Mario-dango/Tank/README.md

This is the first time that I make a real project, I want to do my best on it and finish
