Mario-dango/Tank/mother Tan-k/Archiv/drv8825_3D/8825.stp

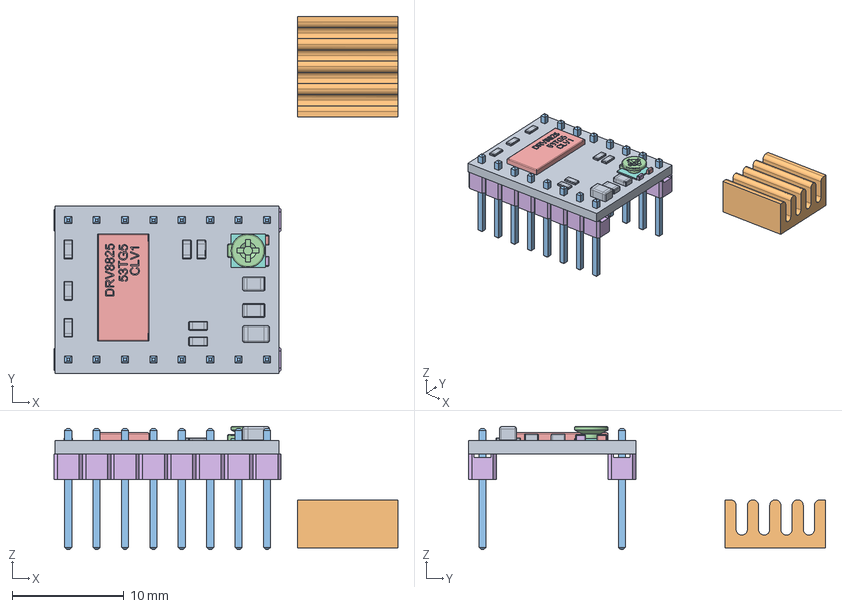
[picture p13: CAD file, 2021-11-19, an earlier design]
mother Tan-k/Archiv/drv8825_3D/8825.stp
30.8 x 31.9 x 11.0 mm
