Mario-dango/Tank/mother Tan-k/Otras versiones/PCB v1.1/Tan-k/Tan-k.kicad_pcb

## KiCad design mother Tan-k/Otras versiones/PCB v1.1/Tan-k/Tan-k.kicad_pcb (2021-11-19, an earlier design)

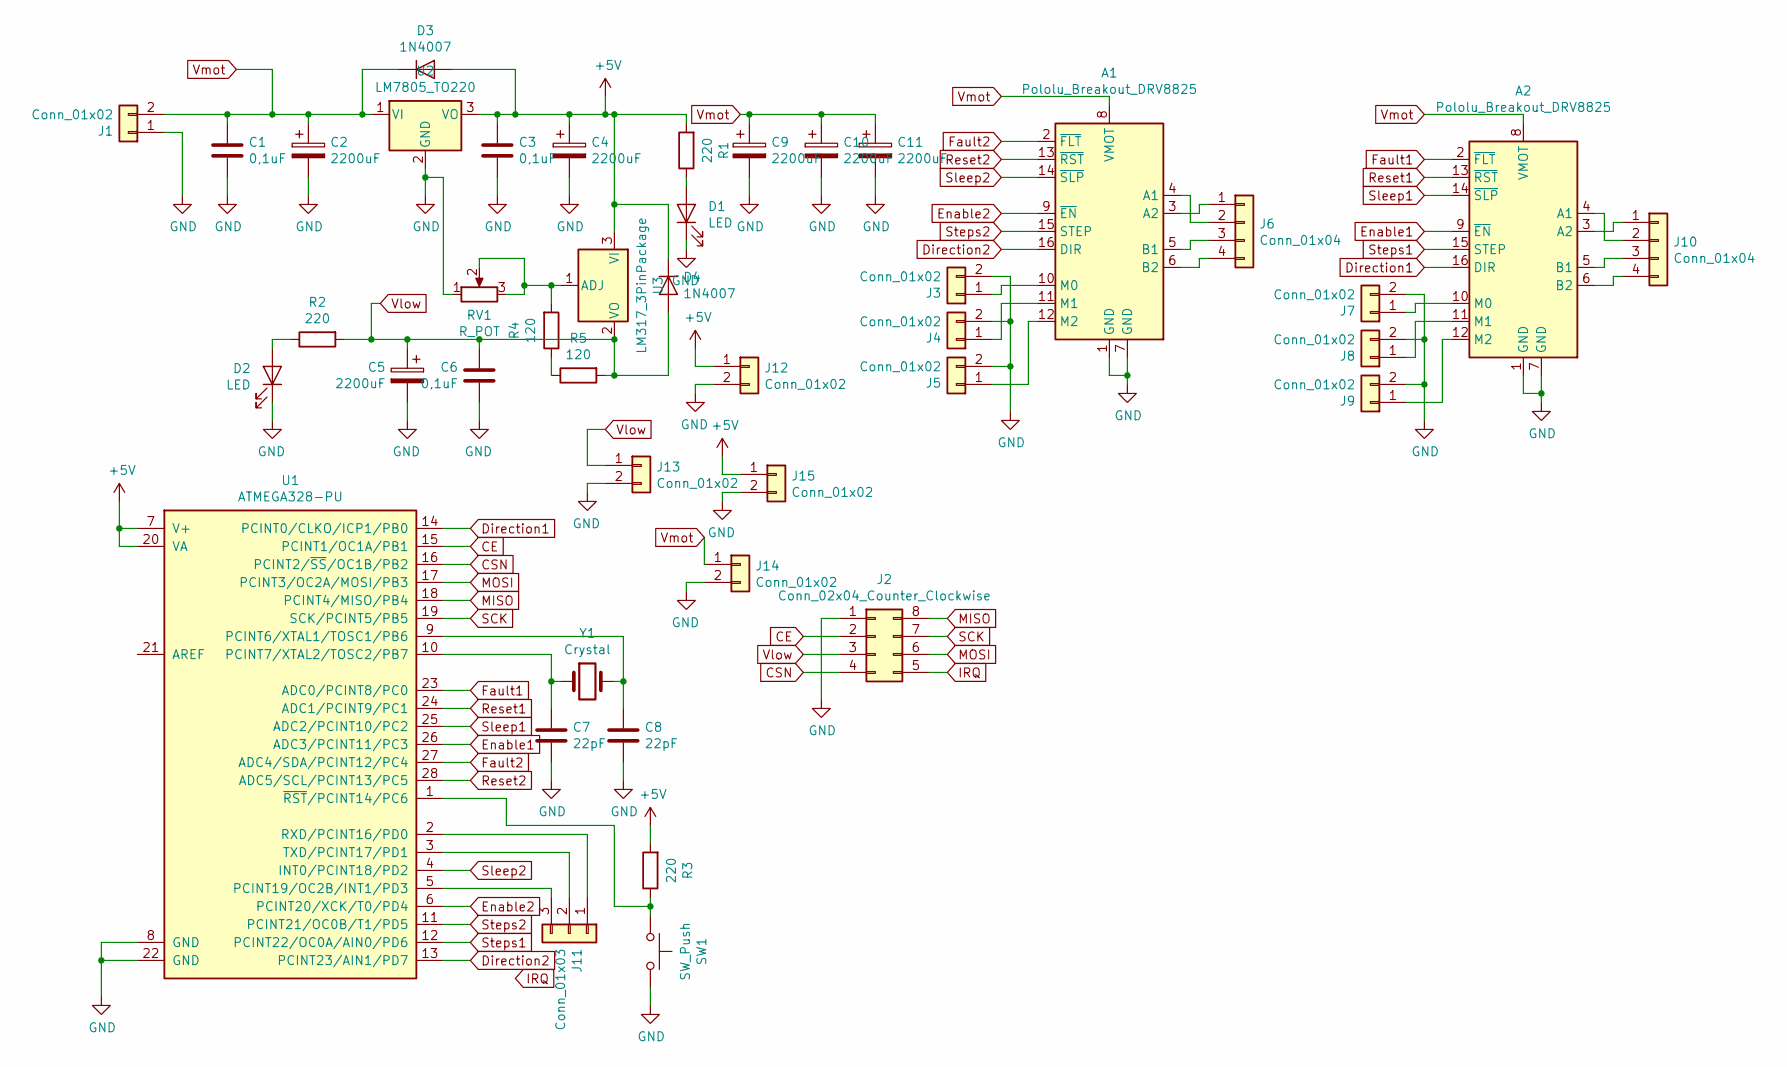
[picture p14: schematic Tan-k.sch]

Parts:
A1, A2: Pololu_Breakout_DRV8825; Pololu_Breakout-16_15.2x20.3mm
C1, C3, C6: 0,1uF; C_Disc_D5.0mm_W2.5mm_P5.00mm
C2, C5: 2200uF; CP_Radial_D10.0mm_P2.50mm_P5.00mm
C4, C9, C10, C11: 2200uF; CP_Radial_D13.0mm_P5.00mm
C7, C8: 22pF; C_Disc_D3.8mm_W2.6mm_P2.50mm
D1, D2: LED; LED_D5.0mm
D3, D4: 1N4007; D_DO-41_SOD81_P10.16mm_Horizontal
J1: Conn_01x02; PhoenixContact_MCV_1,5_2-G-5.08_1x02_P5.08mm_Vertical
J2: Conn_02x04_Counter_Clockwise; PinHeader_2x04_P2.54mm_Vertical
J3, J4, J5, J7, J8, J9, J12, J13, J14, J15: Conn_01x02; PinHeader_1x02_P2.54mm_Vertical
J6, J10: Conn_01x04; PinHeader_1x04_P2.54mm_Vertical
J11: Conn_01x03; PinHeader_1x03_P2.54mm_Vertical
R1, R2, R3: 220; R_Axial_DIN0207_L6.3mm_D2.5mm_P10.16mm_Horizontal
R4, R5: 120; R_Axial_DIN0207_L6.3mm_D2.5mm_P10.16mm_Horizontal
RV1: R_POT; Potentiometer_Bourns_3266X_Horizontal
SW1: SW_Push; SW_PUSH_6mm_H5mm
U1: ATMEGA328-PU; DIP-28_W7.62mm_Socket; MPN ATMEGA328-PU
U2: LM7805_TO220; TO-220-3_Vertical
U3: LM317_3PinPackage; TO-220-3_Vertical
Y1: Crystal; Crystal_HC52-6mm_Vertical

Connections:
+5V: C3.1, C4.1, D3.2 (A), D4.1 (K), J12.1, J15.1, R1.2, R3.2, U1.7 (V+), U1.20 (VA), U2.3 (VO), U3.3 (VI)
CE: J2.2, U1.15 (PCINT1/OC1A/PB1)
CSN: J2.4, U1.16 (PCINT2/~SS~/OC1B/PB2)
Direction1: A2.16 (DIR), U1.14 (PCINT0/CLKO/ICP1/PB0)
Direction2: A1.16 (DIR), U1.13 (PCINT23/AIN1/PD7)
Enable1: A2.9 (~EN), U1.26 (ADC3/PCINT11/PC3)
Enable2: A1.9 (~EN), U1.6 (PCINT20/XCK/T0/PD4)
Fault1: A2.2 (~FLT), U1.23 (ADC0/PCINT8/PC0)
Fault2: A1.2 (~FLT), U1.27 (ADC4/SDA/PCINT12/PC4)
GND: A1.1 (GND), A1.7 (GND), A2.1 (GND), A2.7 (GND), C1.2, C2.2, C3.2, C4.2, C5.2, C6.2, C7.2, C8.2, C9.2, C10.2, C11.2, D1.1 (K), D2.1 (K), J1.1, J2.1, J3.2, J4.2, J5.2, J7.2, J8.2, J9.2, J12.2, J13.2, J14.2, J15.2, RV1.1, SW1.1, U1.8 (GND), U1.22 (GND), U2.2 (GND)
IRQ: J2.5
MISO: J2.8, U1.18 (PCINT4/MISO/PB4)
MOSI: J2.6, U1.17 (PCINT3/OC2A/MOSI/PB3)
unnamed: A1.3 (A2), J6.1
unnamed: A1.4 (A1), J6.2
unnamed: A1.5 (B1), J6.3
unnamed: A1.6 (B2), J6.4
unnamed: A1.10 (M0), J3.1
unnamed: A1.11 (M1), J4.1
unnamed: A1.12 (M2), J5.1
unnamed: A2.3 (A2), J10.1
unnamed: A2.4 (A1), J10.2
unnamed: A2.5 (B1), J10.3
unnamed: A2.6 (B2), J10.4
unnamed: A2.10 (M0), J7.1
unnamed: A2.11 (M1), J8.1
unnamed: A2.12 (M2), J9.1
unnamed: C7.1, U1.10 (PCINT7/XTAL2/TOSC2/PB7), Y1.1
unnamed: C8.1, U1.9 (PCINT6/XTAL1/TOSC1/PB6), Y1.2
unnamed: D1.2 (A), R1.1
unnamed: D2.2 (A), R2.1
unnamed: J11.1, U1.2 (RXD/PCINT16/PD0)
unnamed: J11.2, U1.3 (TXD/PCINT17/PD1)
unnamed: J11.3, U1.5 (PCINT19/OC2B/INT1/PD3)
unnamed: R3.1, SW1.2, U1.1 (~RST~/PCINT14/PC6)
unnamed: R4.1, R5.1
unnamed: R4.2, RV1.2, RV1.3, U3.1 (ADJ)
Reset1: A2.13 (~RST), U1.24 (ADC1/PCINT9/PC1)
Reset2: A1.13 (~RST), U1.28 (ADC5/SCL/PCINT13/PC5)
SCK: J2.7, U1.19 (SCK/PCINT5/PB5)
Sleep1: A2.14 (~SLP), U1.25 (ADC2/PCINT10/PC2)
Sleep2: A1.14 (~SLP), U1.4 (INT0/PCINT18/PD2)
Steps1: A2.15 (STEP), U1.12 (PCINT22/OC0A/AIN0/PD6)
Steps2: A1.15 (STEP), U1.11 (PCINT21/OC0B/T1/PD5)
Vlow: C5.1, C6.1, D4.2 (A), J2.3, J13.1, R2.2, R5.2, U3.2 (VO)
Vmot: A1.8 (VMOT), A2.8 (VMOT), C1.1, C2.1, C9.1, C10.1, C11.1, D3.1 (K), J1.2, J14.1, U2.1 (VI)

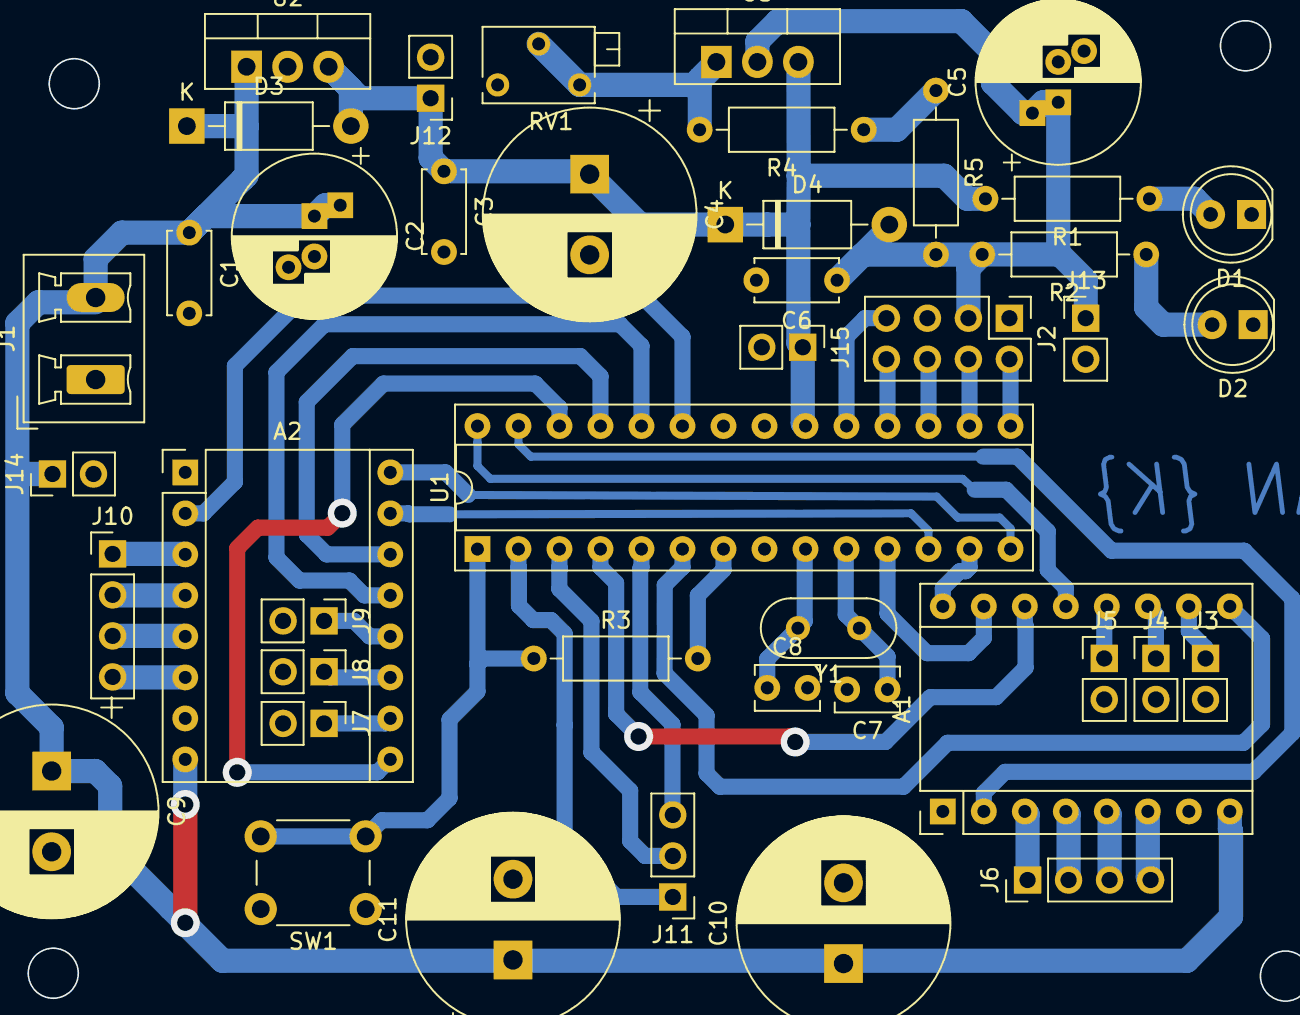
[picture p15: board mother Tan-k/Otras versiones/PCB v1.1/Tan-k/Tan-k.kicad_pcb from above]

Board: 2 copper layers, 43 parts (0 on the bottom side), 45 nets.
